Nick-Z0/Automatic-chicken-door-and-light/images/20220512_192002.jpg

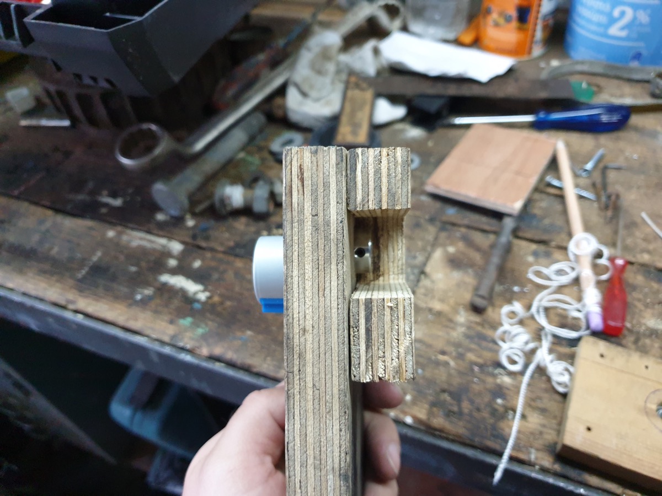
images/20220512_192002.jpg
