Nick-Z0/Automatic-chicken-door-and-light/images/20220512_203612.jpg

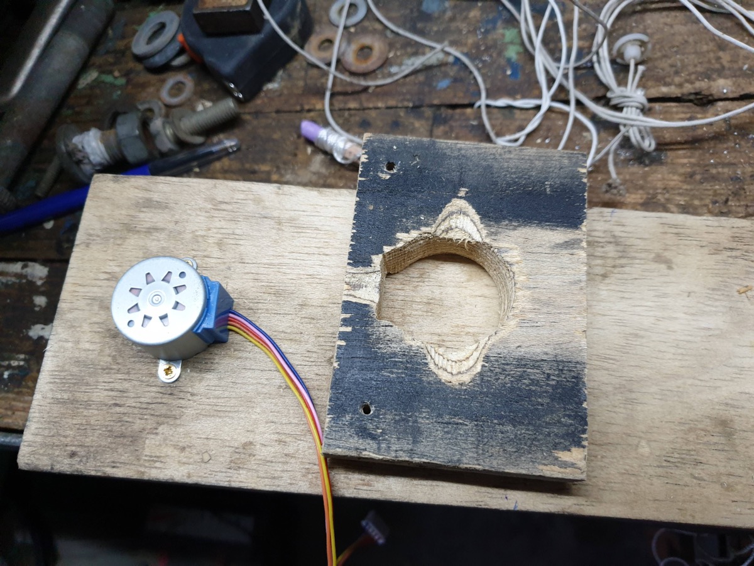
images/20220512_203612.jpg
