Nick-Z0/Automatic-chicken-door-and-light/images/20220512_205746.jpg

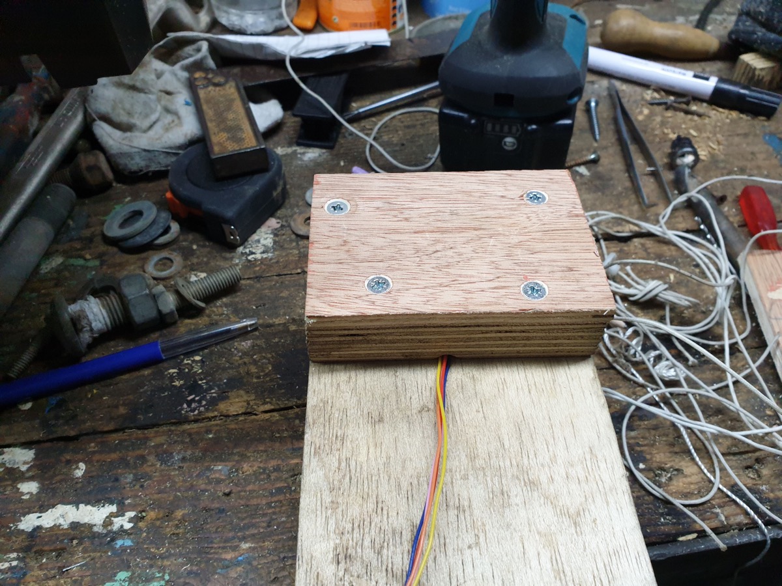
images/20220512_205746.jpg
