Nick-Z0/Automatic-chicken-door-and-light/images/20220512_214621.jpg

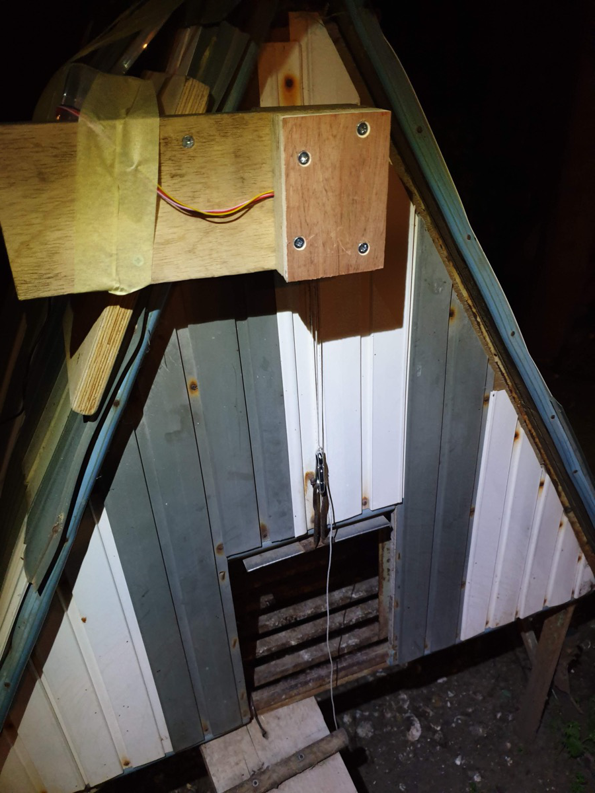
images/20220512_214621.jpg
