Nick-Z0/Automatic-chicken-door-and-light/images/finished-board.jpg

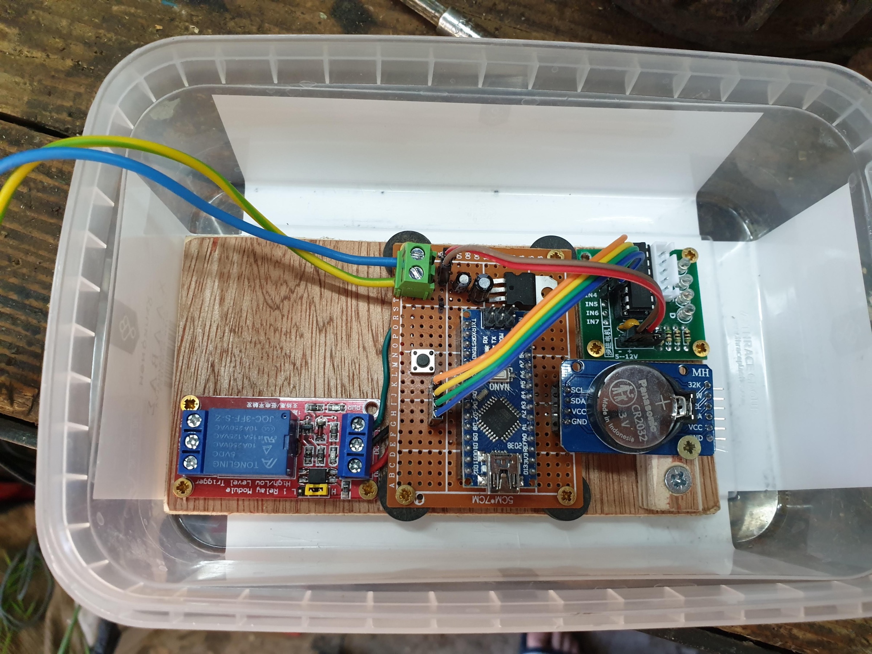
images/finished-board.jpg
