Nick-Z0/Automatic-chicken-door-and-light/schematic/Schematic_automatic_chicken_door.pdf

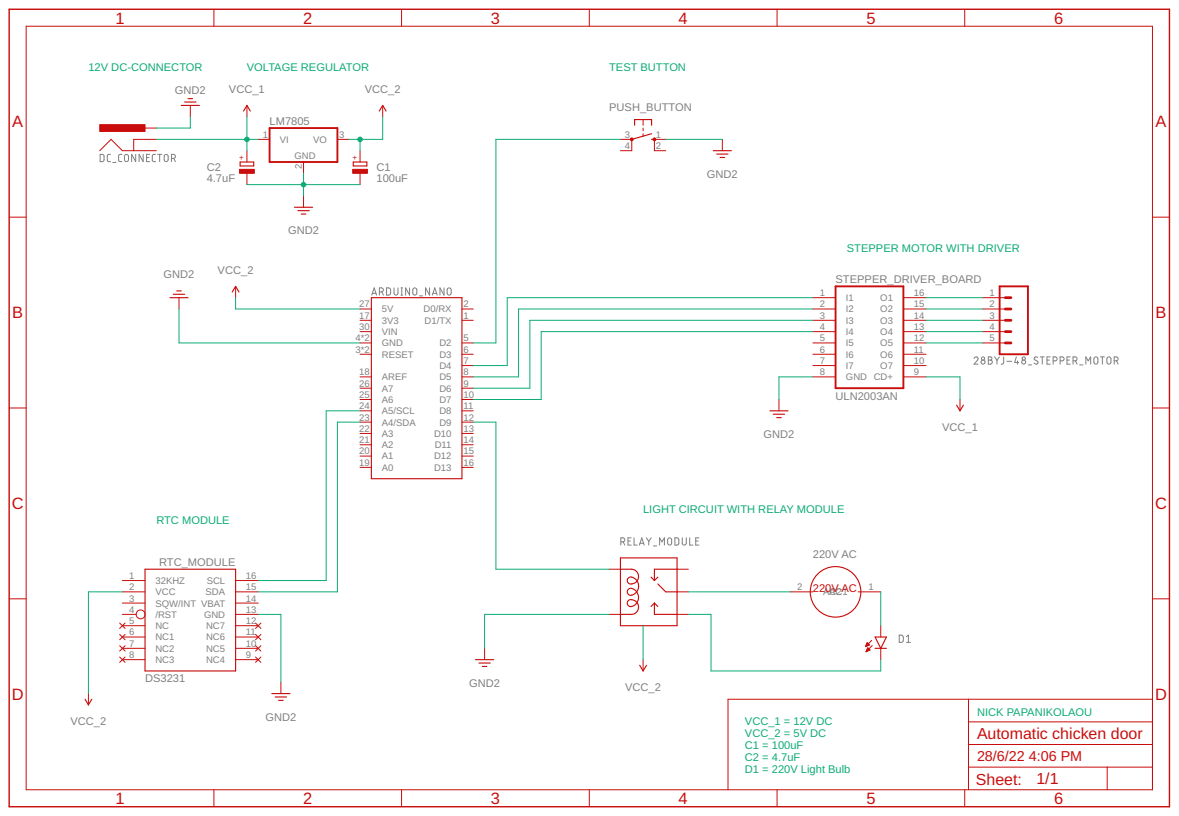
[picture p22: page 1]

STEPPER MOTOR WITH DRIVER

LIGHT CIRCUIT WITH RELAY MODULE
