Nick-Z0/Automatic-chicken-door-and-light/schematic/Schematic_black_automatic_chicken_door.pdf

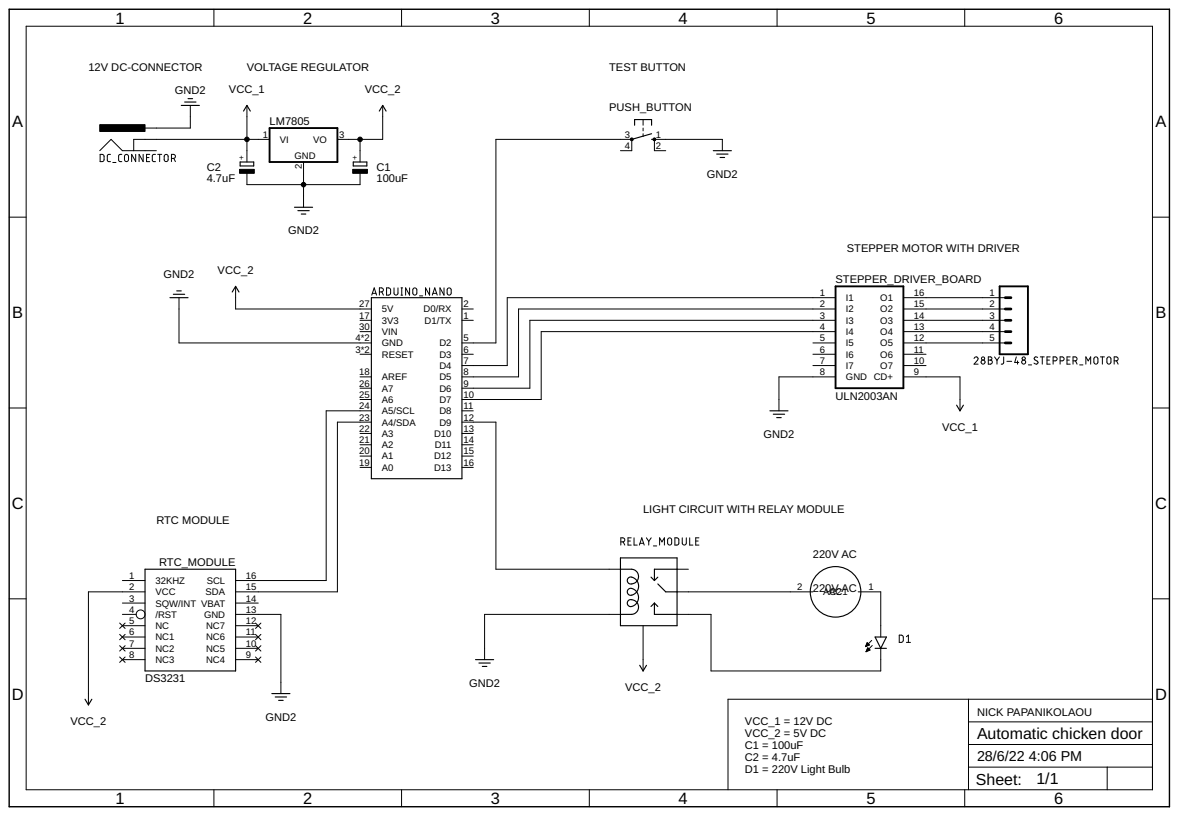
[picture p23: page 1]

STEPPER MOTOR WITH DRIVER

LIGHT CIRCUIT WITH RELAY MODULE
