Nick-Z0/Automatic-chicken-door-and-light/(commit log)

2022-06-28 Update README.md to include schematic
2022-06-28 Add link to explain the relay module in README.md
2022-08-15 Fix delay in test cycle
    [Automatic_chicken_door_and_light.ino]
2022-09-30 Fix interrupt flag after 'upload sketch' issue
    [Automatic_chicken_door_and_light.ino]
2023-03-09 Add minor typo corrections
    [Automatic_chicken_door_and_light.ino]
2024-01-17 Version 2: add physical buttons and other improvements
2024-01-19 Version 2.01: bugfixes and improvements
    [Automatic_chicken_door_and_light.ino]
